MultiMote/kugoo-s3-bluepill/pcb/README.md

Проект DipTrace.

| RefDes | Name | Quantity | Value |
|---|---|---|---|
| C1, C2, C5, C7, C8, C9 | | 6 | 100n |
| C3 | | 1 | 22u |
| C4 | CAP_POLARIZED | 1 | 22u |
| C6 | | 1 | 1u |
| C10 | | 1 | 33n |
| D1 | BZV55-C3V6 | 1 | |
| D2, D5 | BZV55-C5V6 | 2 | |
| D3 | 1N4148W | 1 | |
| D4 | SS16 | 1 | |
| F1 | FUSE | 1 | |
| J1 | JST_1.25mm_2p | 1 | LIGHT |
| J2 | JST_1.25mm_3p | 1 | HALL-BRAKE |
| J3 | JST_1.25mm_3p | 1 | HALL-THROTTLE |
| J4 | JST_1.25mm_2p | 1 | BUZZER |
| J5 | HDR-1x5 | 1 | |
| L1 | | 1 | 100uH |
| LCD1 | SSD1306_i2c | 1 | |
| Q1, Q2, Q6 | KST5551 | 3 | |
| Q3 | 2SA1013 | 1 | |
| Q4, Q5 | BC817-40 | 2 | |
| R1, R9, R12, R13, R16, R20, R22, R25 | | 8 | 1k |
| R2, R3 | | 2 | 10 |
| R4, R7, R8, R10, R15, R17, R18, R19, R23 | | 9 | 10k |
| R5, R6 | | 2 | 22k |
| R11, R21 | | 2 | 4.7k |
| R14 | | 1 | 330 |
| R24 | | 1 | 3.3k |
| S1 | BEEP | 1 | |
| S2 | SET | 1 | |
| S3 | LIGHT | 1 | |
| S4 | SPEED | 1 | |
| S5 | POWER | 1 | |
| U1 | M24C16WMN6 | 1 | |
| U2 | STM32F103C8T6_bluepill | 1 | |
| U3 | REG1117-3.3 | 1 | |
| U4 | XL7005A | 1 | |
