MultiMote/kugoo-s3-bluepill/docs/images/main_screen.png

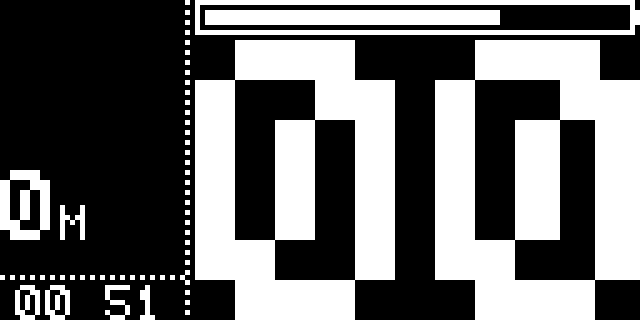
docs/images/main_screen.png
