MultiMote/kugoo-s3-bluepill/pcb/kugoo-s3-bluepill-sch.png

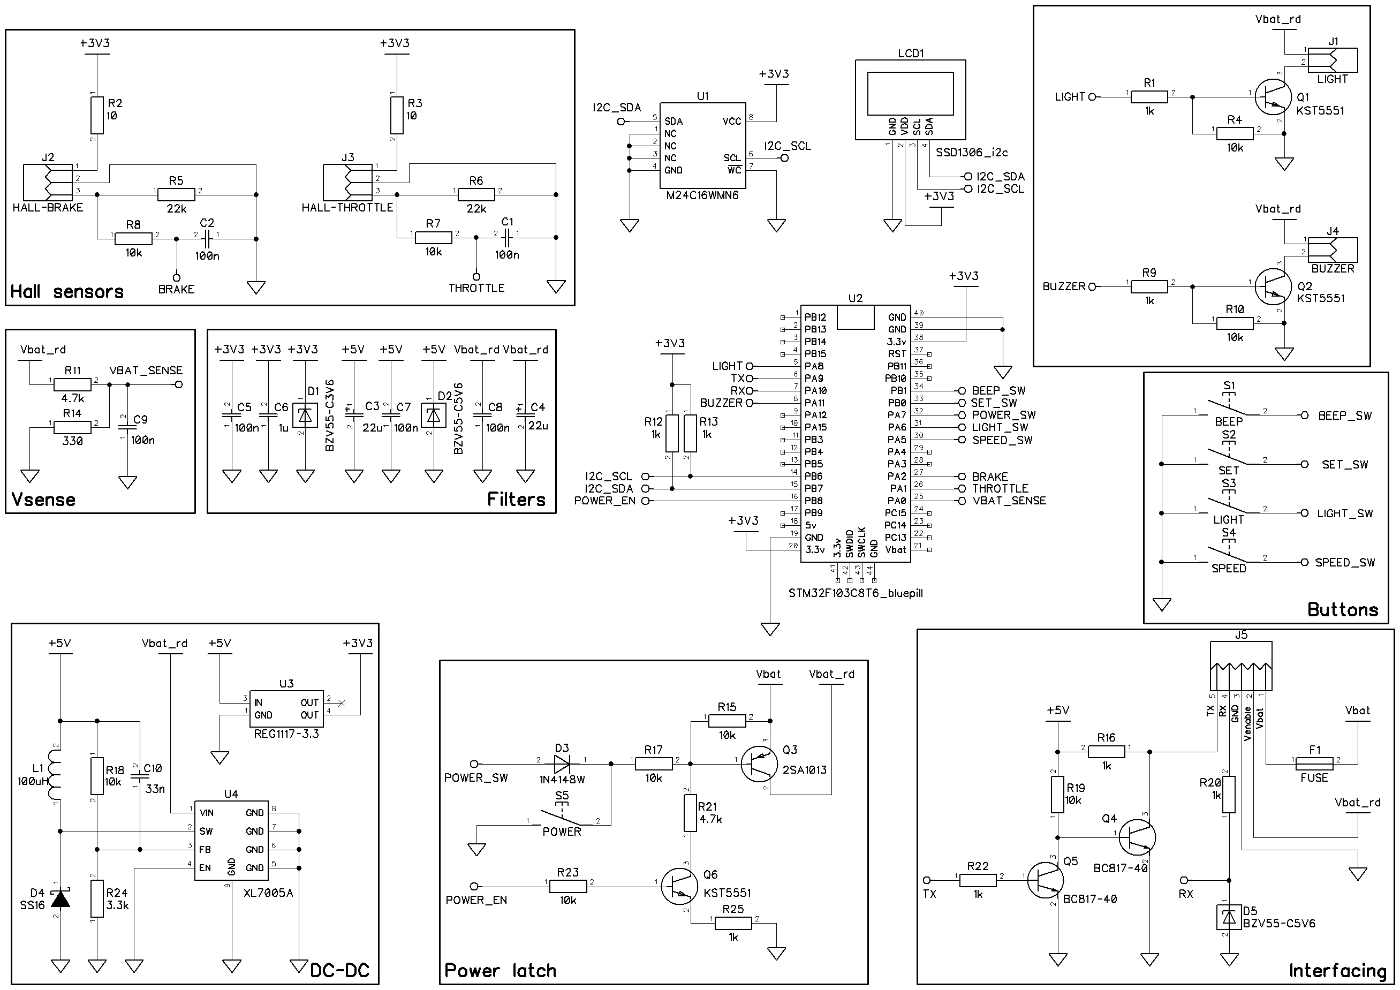
pcb/kugoo-s3-bluepill-sch.png
