MultiMote/kugoo-s3-bluepill/(threads)

Thread 1 (2021-07-28):

GERBER файл

vovo2dev, 2021-07-28:
Здравствуйте, у вас есть возможность выложить разводку платы в формате гербер? Хочу сделать заказ на JLCPCB

MultiMote, 2021-07-30:
Здравствуйте. Проект содержит в себе [плату](https://github.com/MultiMote/kugoo-s3-bluepill/blob/master/pcb/kugoo-s3-bluepill.dip) в формате [DipTrace](https://diptrace.com/rus/download/download-diptrace). В программе можно выполнить экспорт в формат Gerber.

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

Экспорт с настройками по-умолчанию: [kugoo-s3-bluepill_gerber.zip](https://github.com/MultiMote/kugoo-s3-bluepill/files/6908031/kugoo-s3-bluepill_gerber.zip)

Closed 2021-09-02.
