MultiMote/kugoo-s3-bluepill/(list of files, drawings)

Other design files:
pcb/kugoo-s3-bluepill.dch
pcb/kugoo-s3-bluepill.dip
pcb/rev0.3_LM2596/kugoo-s3-bluepill.dch
pcb/rev0.3_LM2596/kugoo-s3-bluepill.dip
