MultiMote/kugoo-s3-bluepill/(commit log)

2021-06-28 Add BOM, fix typos
2021-07-30 PCB poured by default
    [kugoo-s3-bluepill.dip]
